zhujunsan/p3-lte/hardware/pcb/Connector_Back.png

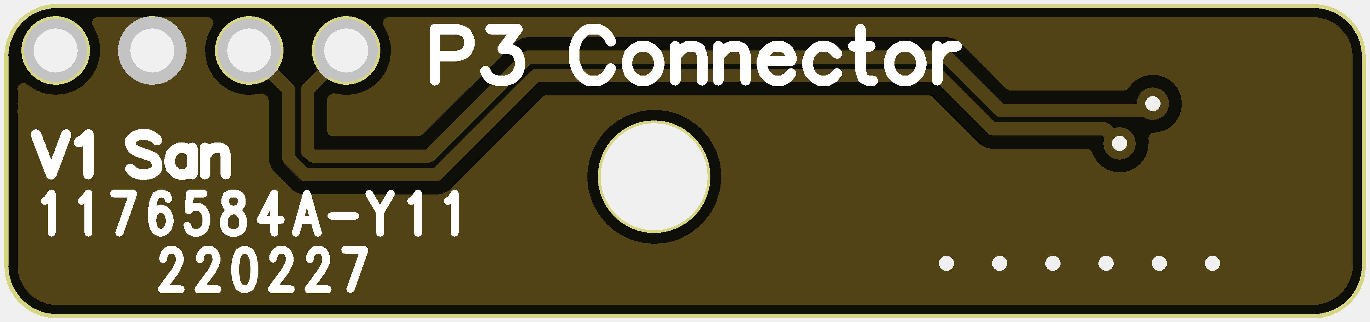
hardware/pcb/Connector_Back.png
