zhujunsan/p3-lte/hardware/pcb/Connector_Front.png

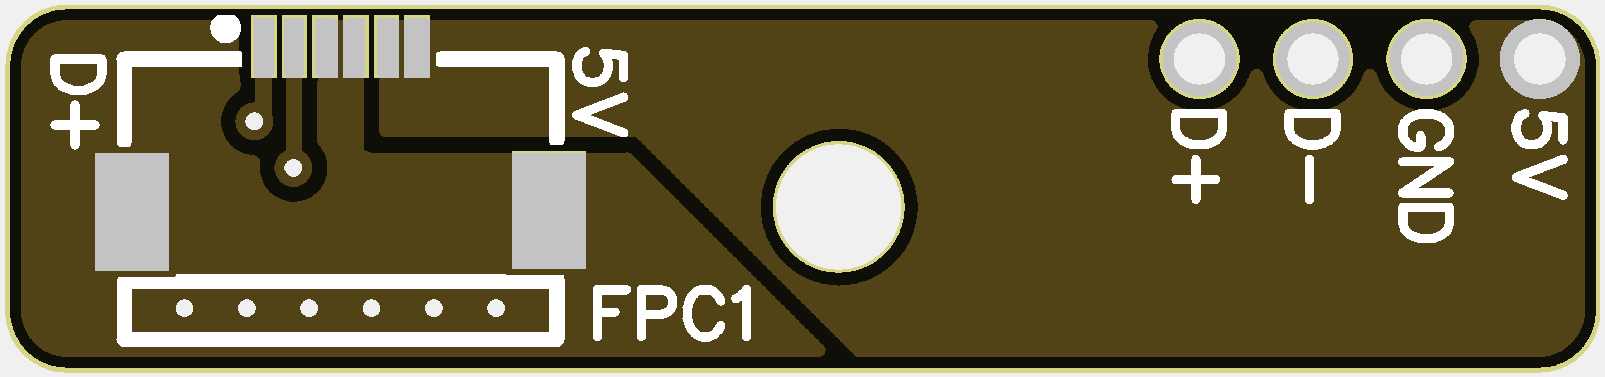
hardware/pcb/Connector_Front.png
