zhujunsan/p3-lte/hardware/pcb/LTE_Module_Back.png

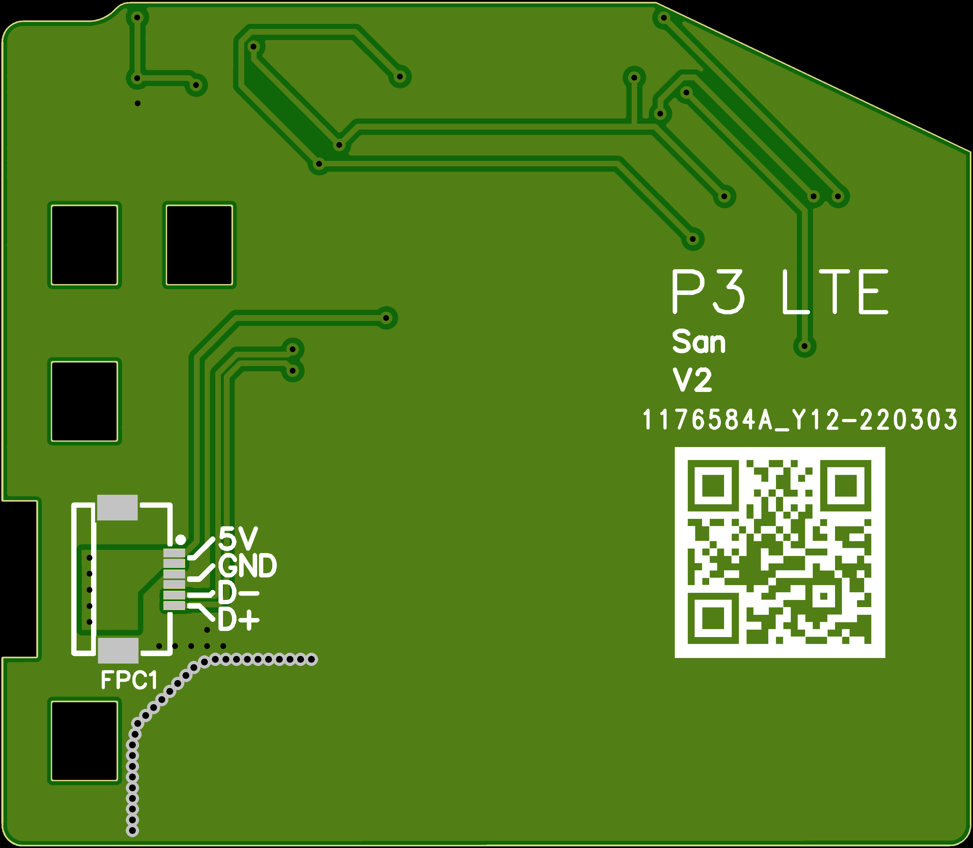
hardware/pcb/LTE_Module_Back.png
