zhujunsan/p3-lte/hardware/pcb/LTE_Module_Front.png

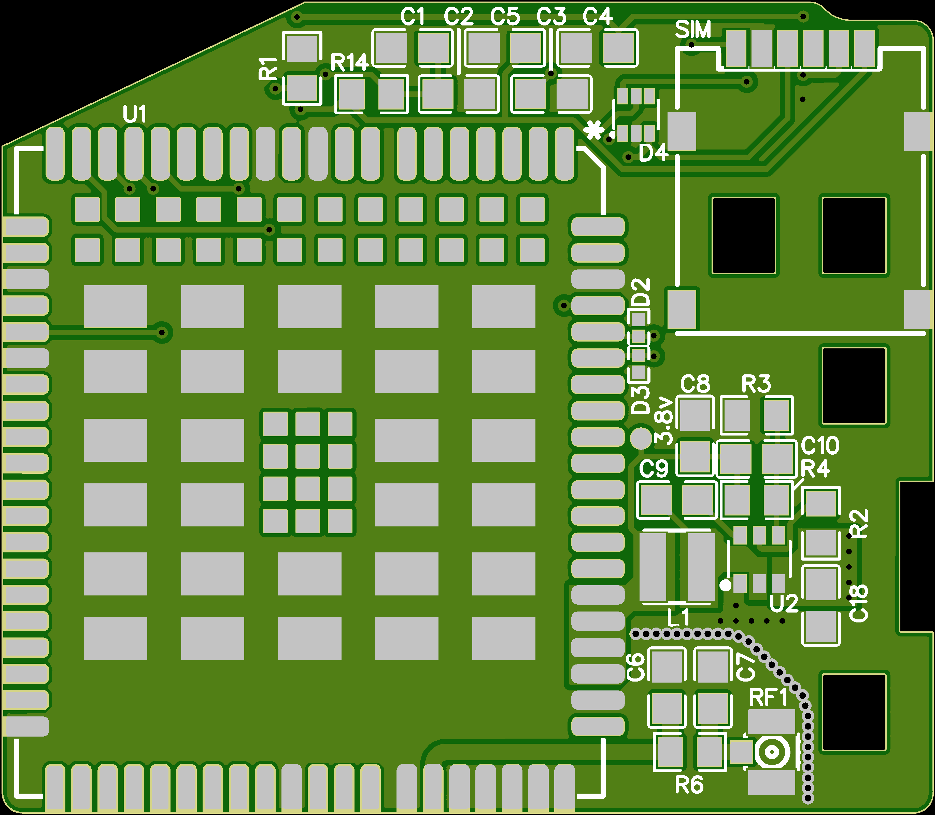
hardware/pcb/LTE_Module_Front.png
