zhujunsan/p3-lte/hardware/model/P3_LTE.step

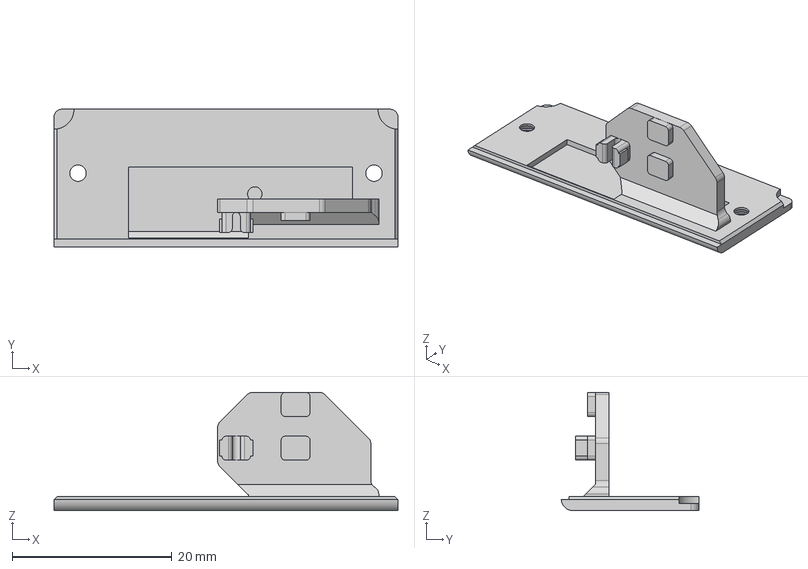
[picture p11: CAD file, 2022-03-23]
hardware/model/P3_LTE.step
43.0 x 17.2 x 14.8 mm
