zhujunsan/p3-lte/(list of files, cad)

Other CAD files:
hardware/model/P3_LTE.f3d
hardware/model/P3_LTE.stl
