zhujunsan/p3-lte/hardware/pcb/Schematic_P3 Connector.pdf

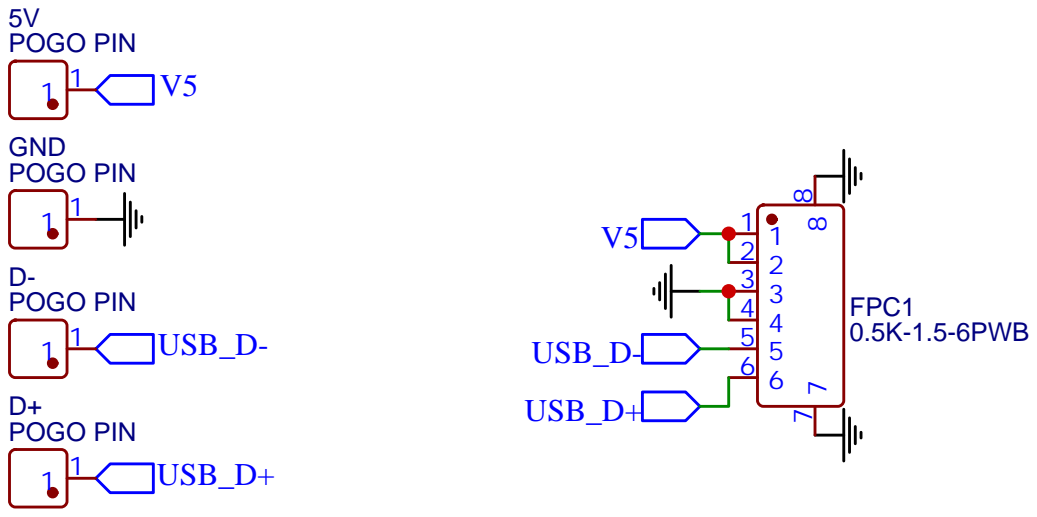
[picture p12: page 1]
