zhujunsan/p3-lte/hardware/pcb/Schematic_P3 Lte.pdf

EC20

V3.8

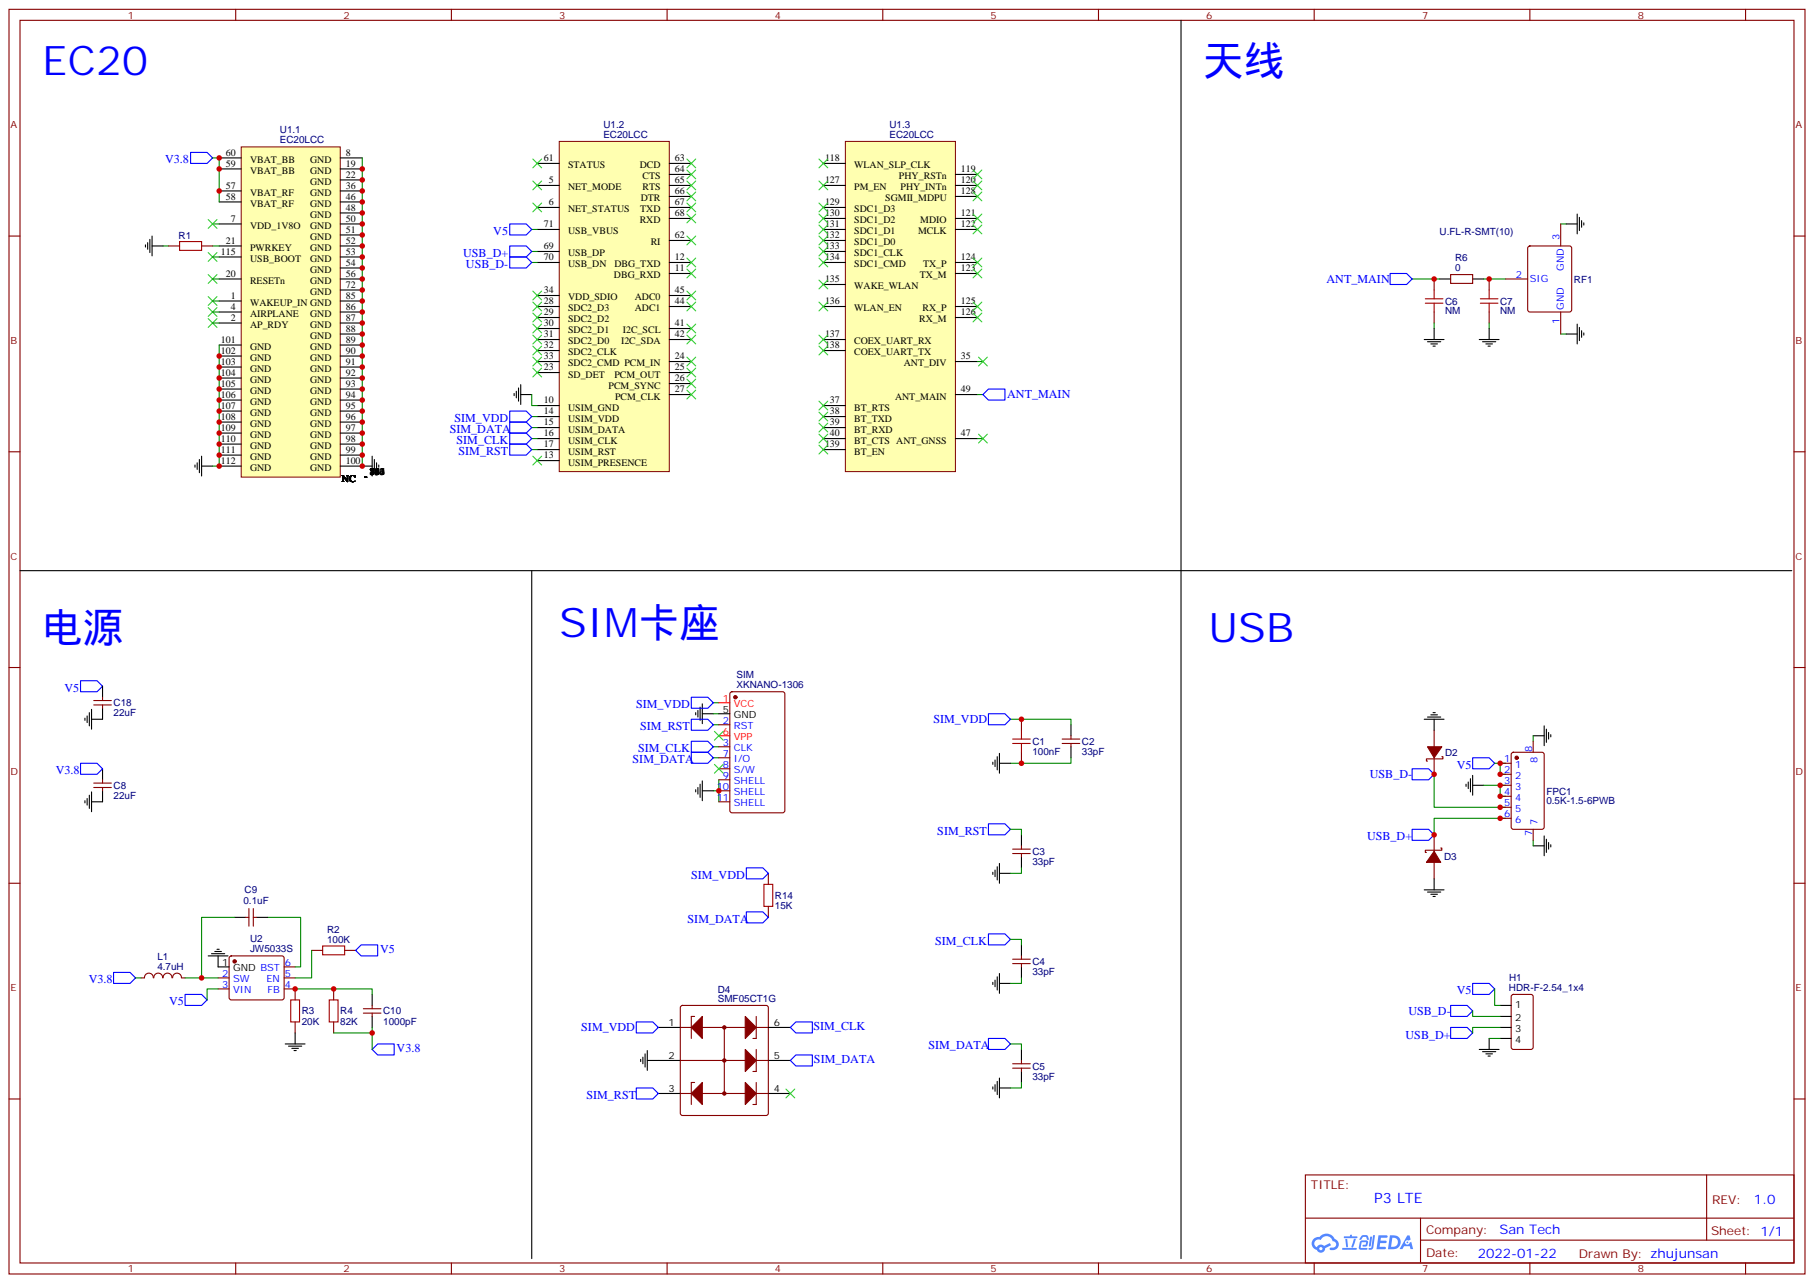
[picture p13: page 1]
