zhujunsan/p3-lte/(threads)

Thread 3 (2022-05-16):

Add the files needed to create the PCB

rina2016, 2022-05-16:
I would like to make this module, but could you upload a file in the following format required to request the production of the board?

pcb:connector LTE_module

pcbname.GTL Surface copper foil
pcbname.GTS Surface solder mask
pcbname.GTO surface silk printing
pcbname.GBL Back side copper foil
pcbname.GBS Back side solder mask
pcbname.GBO Backside silk printing
pcbname.TXT drill
pcbname.GML / GKO Board outline
pcbname.GL2 Internal layer 2 (in the case of 4 or more layers)
pcbname.GL3 Internal layer 3 (in the case of 4 or more layers)

zhujunsan, 2022-05-17:
files' been added in hardware folder as in 63aec99468fc72840a0a33c69ef2079c0c2bac85

Closed 2022-06-03.

Thread 4 (2022-05-31):

I want you to add the data necessary for mounting the parts of the PCB.

rina2016, 2022-05-31:
I would like to request the mounting of parts when manufacturing the board, so I would like you to add files such as coordinate data necessary for mounting the parts.

rina2016, 2022-05-31:
I need the coordinate data to attach the parts, can I output it?
[座標データの例.txt](https://github.com/zhujunsan/p3-lte/files/8803004/default.txt)

rina2016, 2022-05-31:
I need the coordinate data to attach the parts, can I output it
[layout.txt](https://github.com/zhujunsan/p3-lte/files/8803009/layout.txt)
?

zhujunsan, 2022-06-03:
I'm new to pcb design so tell me if i'm wrong. the following files are the maybe modified version gerber files and coordinates file

[Gerber_PCB_P3 Lte_2022_06_03.zip](https://github.com/zhujunsan/p3-lte/files/8832206/Gerber_PCB_P3.Lte_2022_06_03.zip)

[PickAndPlace_PCB_P3 Lte_2022-06-03.csv](https://github.com/zhujunsan/p3-lte/files/8832204/PickAndPlace_PCB_P3.Lte_2022-06-03.csv)

Closed 2022-08-11.

Thread 5 (2022-08-08):

我想知道连接器的探针间距是多少

MengYang37, 2022-08-08:
我想知道连接器的探针间距是多少，方便我采购

zhujunsan, 2022-08-08:
我用手测量的是1.8mm，所以这么设计了。因为只用了四个触点，所以略有一点误差应该也问题不太大
淘宝上我找过问过了没有现成的4个一起的元件，只能一个个自己搞。
然后记得要买加细的，加细的直径1mm，默认的直径1.5。以及不要底下焊盘的，加细的1mm，焊盘1.5mm，间距太小了不太好搞

zhujunsan, 2022-08-08:
如果你有找到现成4个一体的那种还烦请分享一下哈

MengYang37, 2022-08-08:
我找到的最小间距的是1.9mm的4P

MengYang37, 2022-08-08:
我准备把16个脚全引出来，两个USB2.0，一个USB3.0，我手动测量应该在1.6左右，但我没找到一体的

zhujunsan, 2022-08-10:
> 我准备把16个脚全引出来，两个USB2.0，一个USB3.0，我手动测量应该在1.6左右，但我没找到一体的

你如果要16个pin全引出的话精度要求更高了就...

zhujunsan, 2022-08-10:
> https://item.taobao.com/item.htm?_u=81s8tbde106d&id=668109629278

哟感谢，我去买来试一下尺寸

MengYang37, 2022-08-10:
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
这是我昨晚一边画一遍打印比划得到的相对吻合的间距

MengYang37, 2022-08-10:
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
实际画的图

zhujunsan, 2022-08-11:
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

MengYang37, 2022-08-24:
能请你帮忙测试一下这个接口吗，我这边测试这个接口无法识别USB3.0

zhujunsan, 2022-08-24:
> 能请你帮忙测试一下这个接口吗，我这边测试这个接口无法识别USB3.0

我好像暂时没法引出来全部的触点，不过自带的模块就是转3.0A口呀。你那边有模块么？

MengYang37, 2022-08-25:
我就是用自带的模块测的，虽然是3.0的口，并且全部引出，但3.0U盘插上去识别出来的是2.0，其他两个USB3.0口可正常识别

MengYang37, 2022-08-25:
我想扔一个5G模块进去，需要USB3.0接口

zhujunsan, 2022-08-25:
> 我就是用自带的模块测的，虽然是3.0的口，并且全部引出，但3.0U盘插上去识别出来的是2.0，其他两个USB3.0口可正常识别

这个我没问题，可以识别 3.0。这个口的 3.0 是 Gen1 的，5Gbps 的速度。另两个侧面的口是 Gen2 的

zhujunsan, 2022-08-25:
> 我想扔一个5G模块进去，需要USB3.0接口

哈哈哈你能找到能塞得进去的 5G 模块么？感觉尺寸上完全不行，整个塞进去的模块厚度大概只能 3mm 多一点，大小也比较小，天线也不好搞

MengYang37, 2022-08-25:
这不就是盯上了电脑的5G网卡，3042的尺寸，挤挤勉强放得下，得研究3.0的接线

Closed 2024-12-10.

Thread 8 (2024-12-10):

Some issues with parts selection

wjdtkd9977, 2024-12-10:
Hi.
I would like to make LTE module for Pocket 3 through JLCPCB.
However, there were some unidentified factors from the person in charge.
Could you tell me missing parts' information?

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

zhujunsan, 2024-12-10:
| Name | Part | Comment |
| --- | --- | ---|
| C6, C7  | Capacitor | default to be empty, for better radio performance (but i don't know how to find best capacitance, only according to the design menu for the module) |
| D2, D3 | ESD Protector | https://item.szlcsc.com/11206.html?fromZone=s_s__%2522C10662%2522 , or similar. can be ignored, just for extra protection |
| U1 | 4G Module from Quectel | EC20 or other pin compatible modules. JLCPCB don't have this part, you might needed to buy it yourself. And, do pay attention about the region the module works in (such as CN/EU/US), 'cause different countries uses different radio band for 4G communication |

wjdtkd9977, 2024-12-11:
Thank you for the replying my comment.
If I add extra protections for **C6** and **C7**, is it okay to add capacitor such as **C9(C0805 0.1uF)**?

I don't have such these experiences.

zhujunsan, 2024-12-11:
I also don't.

C6, C7 capacitors are not for protection but for fine tune signal strength, I strongly recommend to leave them empty if you're not familiar with those thing.

wjdtkd9977, 2024-12-13:
Thanks.
The main part, "LTE PCB" is ready to manufacture.

Now I'll do self soldering with "Connector PCB".
I've found the clue that, connection part is **0.5K-1.5-6PWB**.

Is there any clue about flexible connector to find myself?

zhujunsan, 2024-12-13:
6pin with a spacing of 0.5mm, about 30mm length, connection on the same side

like these：
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

and I think the pogo pins on the connection board is harder to find and solder
