zhujunsan/p3-lte/(commit log)

2022-03-23 git init
    [P3_LTE.f3d, P3_LTE.step, P3_LTE.stl]
2022-03-24 文案优化
2022-05-17 Add PCB manufacturing files
2022-05-17 Add PCB manufacturing files 2
2023-03-27 更新更合适的天线和外壳图片
    & yarn upgrade
